abranch6/WAR_Button/Documentation/Component List.xlsx

Component | URL | Form Factor | PCB ID
BC118 | http://www.digikey.com/product-detail/en/BC118/1495-1003-1-ND/4860037 |  | BLE1
ATTiny84A | http://www.digikey.com/product-detail/en/ATTINY84A-MUR/ATTINY84A-MURCT-ND/2774135 | QFN20 | IC1
100K Resistors | http://www.digikey.com/product-detail/en/MCR03ERTF1003/RHM100KCFCT-ND/2796461 | 0603 SMD | R4, R5
100 Ohm Resistors (Red LED) | http://www.digikey.com/product-detail/en/MCR03ERTF1000/RHM100CFCT-ND/2796458 | 0603 SMD | R1
75 Ohm Resistors (Green LED) | http://www.digikey.com/product-detail/en/MCR03ERTF75R0/RHM75.0CFCT-ND/2796492 | 0603 SMD | R3
25.5K Resistor (Smaller Battery) | http://www.digikey.com/product-detail/en/MCR03ERTF2552/RHM25.5KCFCT-ND/4084087 | 0603 SMD | R2
Red LED | http://www.digikey.com/product-detail/en/SML-LX0603SRW-TR/67-1551-1-ND/304364 | 0603 SMD | D1
Green LED | http://www.digikey.com/product-detail/en/SML-LX0603SUGW-TR/67-1693-1-ND/467578 | 0603 SMD | D2
10 nF Cap | http://www.digikey.com/product-detail/en/GRM188R71H103KA01D/490-1512-1-ND/587862 | 0603 SMD | C3
4.7 uF Cap | http://www.digikey.com/product-detail/en/GRM188R60J475KE19D/490-3297-1-ND/702838 | 0603 SMD | C1,C2
1 uF Cap | http://www.digikey.com/product-detail/en/GRM188R61A105KA61D/490-1543-1-ND/587782 | 0603 SMD | C4
Micro USB | http://www.digikey.com/product-detail/en/10118192-0001LF/609-4613-1-ND/2785378 |  | P1
JST Connector | https://www.sparkfun.com/products/8612 |  | P2
LiPo Battery | https://www.sparkfun.com/products/11316
Switch | http://www.digikey.com/product-detail/en/EVQ-P2602W/P12301SCT-ND/593601 | EVQP2 | SW1, SW2
MCP73831 | http://www.digikey.com/product-detail/en/MCP73831T-2ACI%2FOT/MCP73831T-2ACI%2FOTCT-ND/1979802 | SOT-23-5 | Q1
P-MOSFET | http://www.digikey.com/product-detail/en/NTR2101PT1G/NTR2101PT1GOSCT-ND/687131 | SOT23 | Q2
