abranch6/WAR_Button/(list of files, drawings)

Other design files:
PCB/KiCad_Project/WAR_Button.dsn
