abranch6/WAR_Button/PCB/KiCad_Project/WAR_Button.kicad_pcb

## KiCad design PCB/KiCad_Project/WAR_Button.kicad_pcb (2015-11-13)

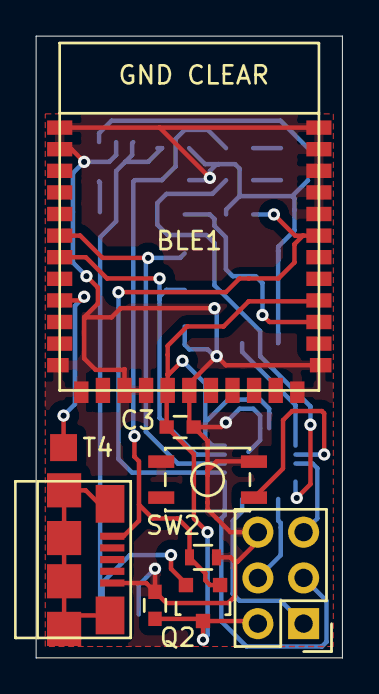
[picture p1: board WAR_Button.kicad_pcb from above]

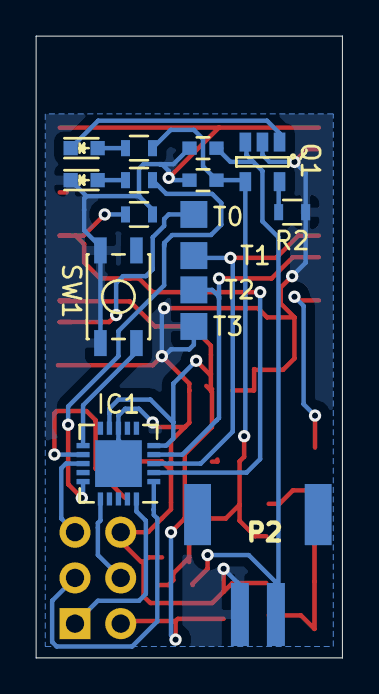
[picture p2: board WAR_Button.kicad_pcb from below]

Board: 2 copper layers, 17.0 x 34.5 mm, 25 parts (16 on the bottom side), 20 nets.

Parts:
BLE1: BC118; bc118
C1, C2: 4.7uF; C_0603
C3: 10nF; C_0603
C4: 1uF; C_0603
D1, D2: LED; LED-0603
IC1: ATTINY84A-M; qfn20
P1: USB_OTG; USB_Micro-B
P2: BATT; JST_2
P3: HEADER; Pin_Header_Straight_2x03
Q1: MCP73831; SOT-23-5
Q2: NTR2101PT1G; SOT-23
R1, R3: LED_R; R_0603
R2: PROG; R_0603
R4, R5: 100K; R_0603
SW1, SW2: SW_PUSH; SW_SPST_EVQP2
T0: T0; Measurement_Point_Square-SMD-Pad_Small
T1: T1; Measurement_Point_Square-SMD-Pad_Small
T2: T2; Measurement_Point_Square-SMD-Pad_Small
T3: T3; Measurement_Point_Square-SMD-Pad_Small
T4: T4; Measurement_Point_Square-SMD-Pad_Small

Connections:
BATT_VCC: C2.2, P2.2, Q1.3, Q2.2
BLED1: BLE1.9, T4.1
BLED2: BLE1.26, T0.1
BLE_RX: BLE1.7, IC1.4, T2.1
BLE_TX: BLE1.6, IC1.3, T1.1
LOAD_VCC: BLE1.17, BLE1.27, C3.2, C4.2, IC1.5, IC1.9, P3.2, Q2.3
unnamed: D1.1, Q1.1
unnamed: D1.2, R1.2
unnamed: D2.2, R3.1
unnamed: IC1.11, SW1.1
unnamed: IC1.12, SW2.1
unnamed: IC1.15, R3.2
unnamed: Q1.5, R2.1
P1: IC1.1, P3.3
P2: IC1.20, P3.1
P3: IC1.16, P3.4
P4: IC1.13, P3.5
PROG_GND: BLE1.1, BLE1.2, BLE1.12, BLE1.13, BLE1.15, BLE1.16, BLE1.18, BLE1.23, BLE1.24, BLE1.31, BLE1.32, BLE1.33, BLE1.34, BLE1.35, C1.2, C2.1, C3.1, C4.1, D2.1, IC1.8, IC1.21, P1.5, P2.1, P3.6, Q1.2, R2.2, R4.2, R5.1, SW1.2, SW2.2, T3.1
USB_VCC: C1.1, P1.1, Q1.4, Q2.1, R1.1, R5.2
WAKE: BLE1.30, IC1.2, R4.1
