abranch6/WAR_Button/(commit log)

2015-09-23 Added BLE2 Mate Library
    [BLE_Mate2-Panel-v10.brd, SparkFun_BLEMate2.brd, SparkFun_BLEMate2.sch]
2015-10-14 Added PCB design for KiCad
    [WAR_Button.kicad_pcb, WAR_Button.sch]
2015-10-14 WAR Button main arduino code
2015-10-15 Updated Schematic
    [WAR_Button.sch]
2015-10-19 -Updated pin numbers to match with schematic
2015-10-28 Added footprints
2015-10-29 Updated Button code Updated Schematic
    [WAR_Button.sch]
2015-11-08 -Finished PCB Design
    [WAR_Button.dsn, WAR_Button.sch]
2015-11-12 Added MOSFET
    [WAR_Button.kicad_pcb, WAR_Button.sch]
2015-11-13 Added GERBER and Drill files
    [WAR_Button-B_Cu.gbl, WAR_Button-B_Mask.gbs, WAR_Button-B_SilkS.gbo, WAR_Button-Edge_Cuts.gm1, WAR_Button-F_Cu.gtl, WAR_Button-F_Mask.gts, WAR_Button-F_SilkS.gto, WAR_Button.drl]
2015-11-29 Added timeouts to button presses
2015-12-02 Added device communication
2015-12-02 updated arduino sketch
2015-12-02 refined the button press
2015-12-02 Fixed button change issue cleaned up device code
    [WAR_Arduino.ino]
2015-12-02 Cleaned up arduino code added longer scan time for android
2015-12-02 Added component list
    [Component List.xlsx]
2015-12-03 updated arduino code
2015-12-04 removed extra stuff from the repo
    [BLE_Mate2-Panel-v10.brd, SparkFun_BLEMate2.brd, SparkFun_BLEMate2.sch]
2015-12-04 Added CONTENTS text file Clarified the schematic for the device.
    [WAR_Button.sch]
